VendeinRaZoR/AVC1READER/Agilent 93000 Documentation/Photos/2.bmp

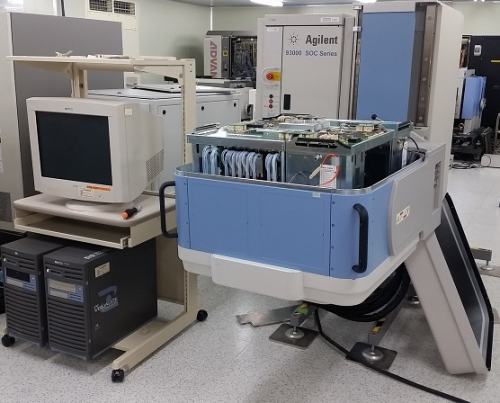
Agilent 93000 Documentation/Photos/2.bmp
