VendeinRaZoR/AVC1READER/Agilent 93000 Documentation/Photos/4.bmp

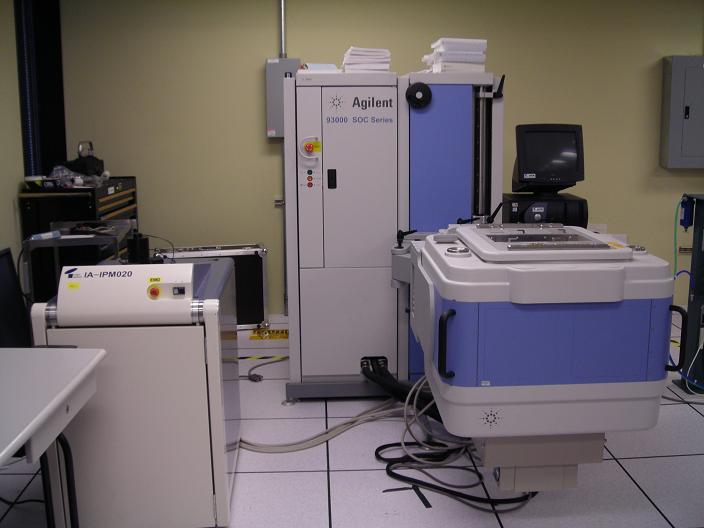
Agilent 93000 Documentation/Photos/4.bmp
