VendeinRaZoR/AVC1READER/Agilent 93000 Documentation/Photos/5.bmp

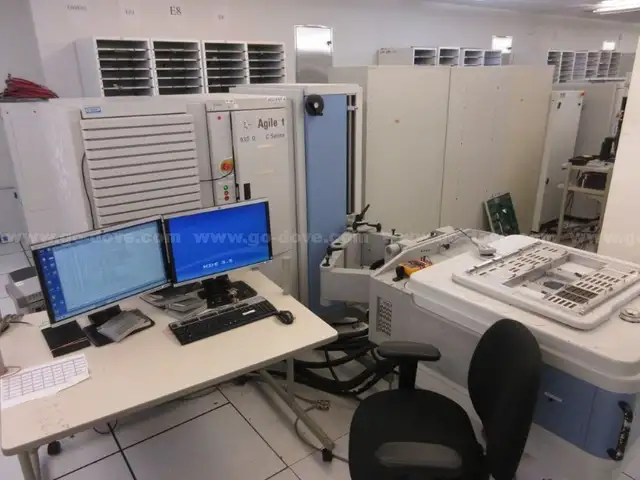
Agilent 93000 Documentation/Photos/5.bmp
