VendeinRaZoR/AVC1READER/Agilent 93000 Documentation/Photos/6.bmp

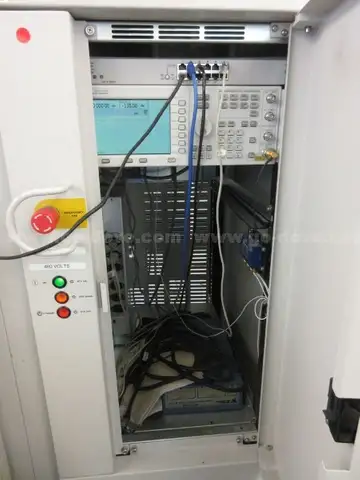
Agilent 93000 Documentation/Photos/6.bmp
