VendeinRaZoR/AVC1READER/Agilent 93000 Documentation/Photos/7.bmp

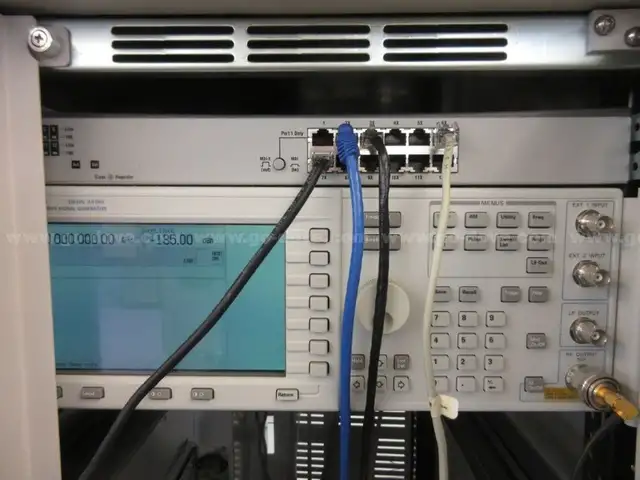
Agilent 93000 Documentation/Photos/7.bmp
