VendeinRaZoR/AVC1READER/Agilent 93000 Documentation/Photos/8.bmp

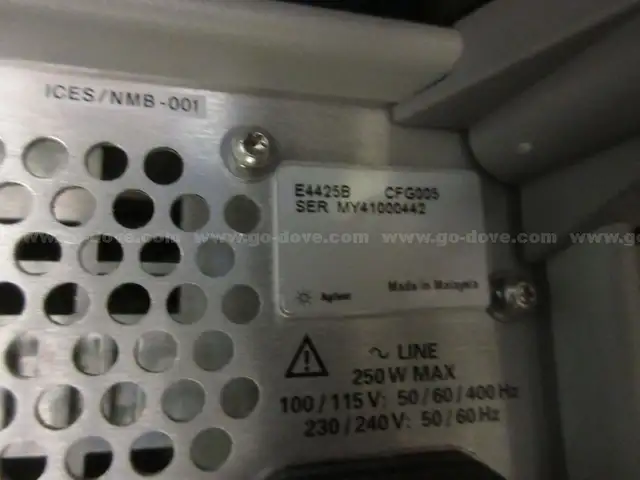
Agilent 93000 Documentation/Photos/8.bmp
