VendeinRaZoR/AVC1READER/Agilent 93000 Documentation/Photos/9.bmp

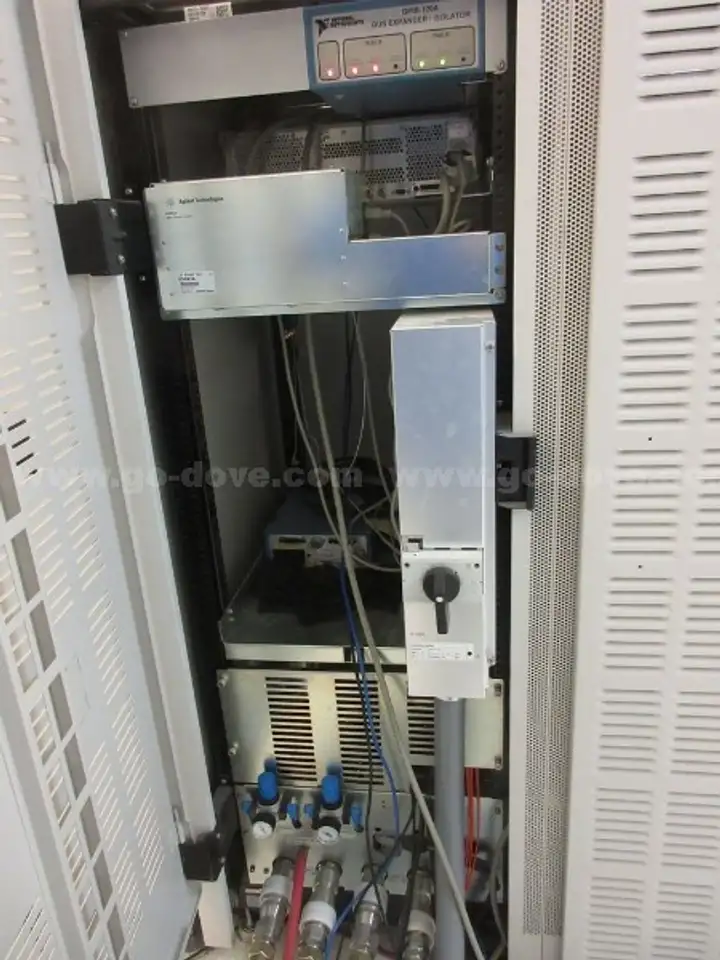
Agilent 93000 Documentation/Photos/9.bmp
