VendeinRaZoR/AVC1READER/Agilent 93000 Documentation/Photos/10.bmp

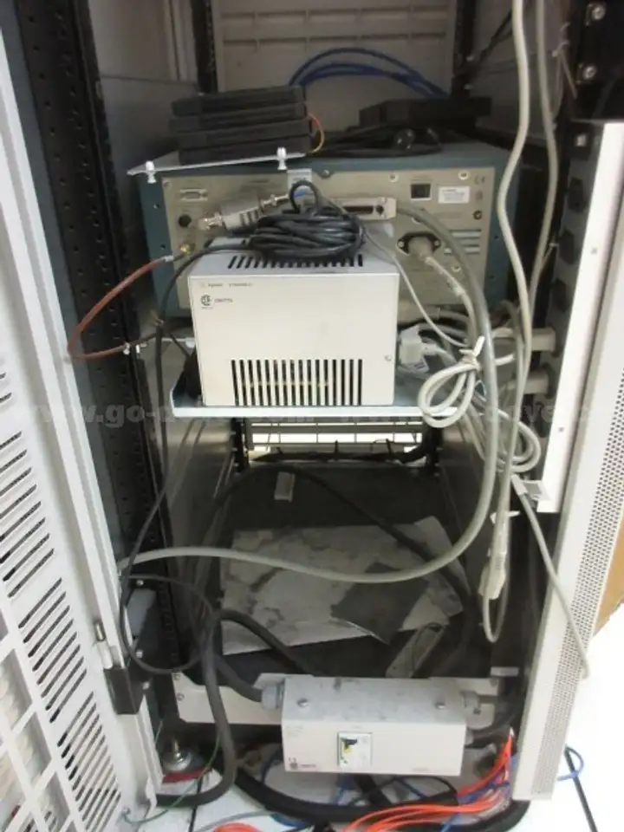
Agilent 93000 Documentation/Photos/10.bmp
