VendeinRaZoR/AVC1READER/Agilent 93000 Documentation/Photos/11.bmp

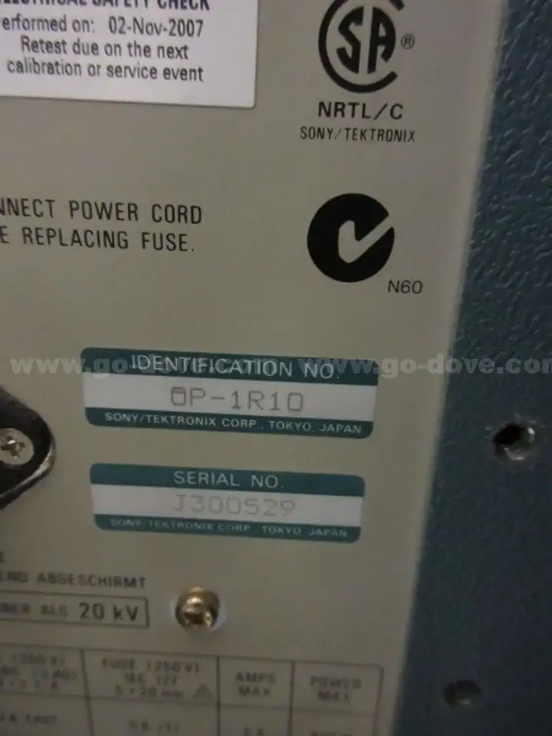
Agilent 93000 Documentation/Photos/11.bmp
