VendeinRaZoR/AVC1READER/Agilent 93000 Documentation/Photos/12.bmp

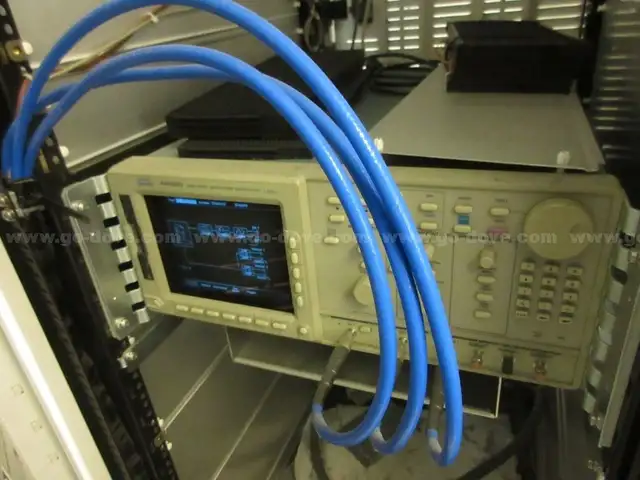
Agilent 93000 Documentation/Photos/12.bmp
