VendeinRaZoR/AVC1READER/Agilent 93000 Documentation/Photos/13.bmp

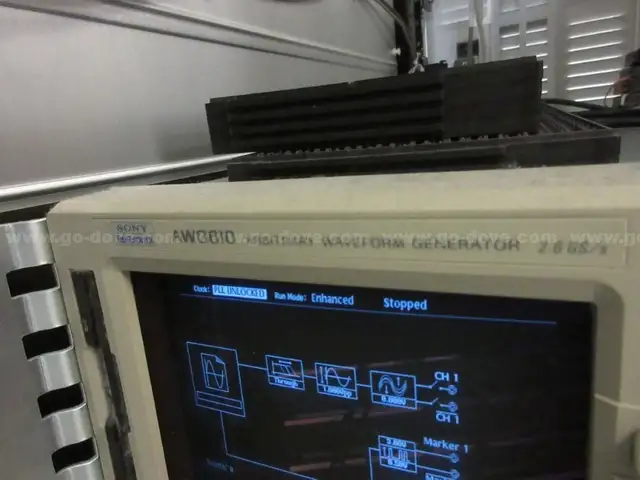
Agilent 93000 Documentation/Photos/13.bmp
