VendeinRaZoR/AVC1READER/Agilent 93000 Documentation/Photos/14.bmp

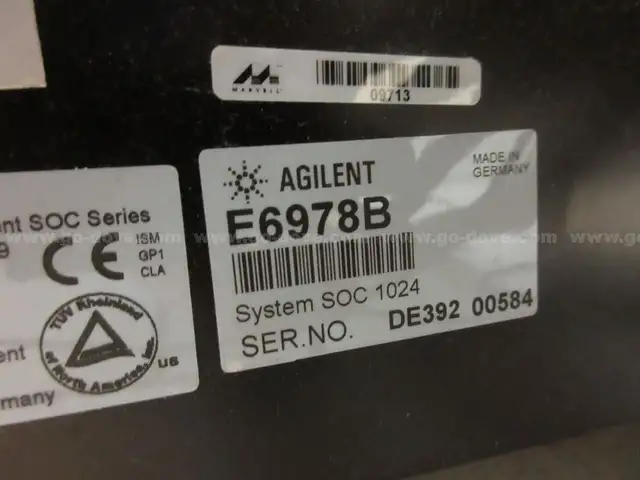
Agilent 93000 Documentation/Photos/14.bmp
