VendeinRaZoR/AVC1READER/Agilent 93000 Documentation/Photos/15.bmp

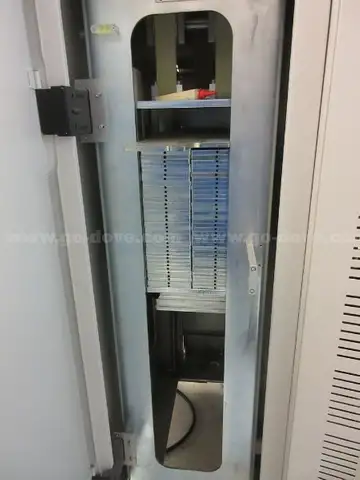
Agilent 93000 Documentation/Photos/15.bmp
