VendeinRaZoR/AVC1READER/Agilent 93000 Documentation/Photos/16.bmp

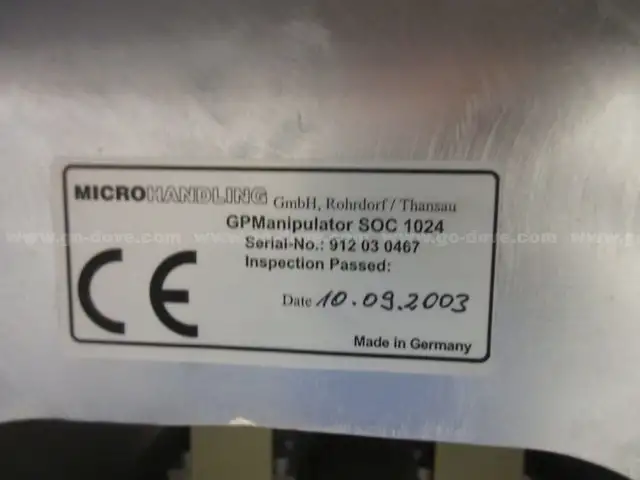
Agilent 93000 Documentation/Photos/16.bmp
