VendeinRaZoR/AVC1READER/Agilent 93000 Documentation/Photos/17.bmp

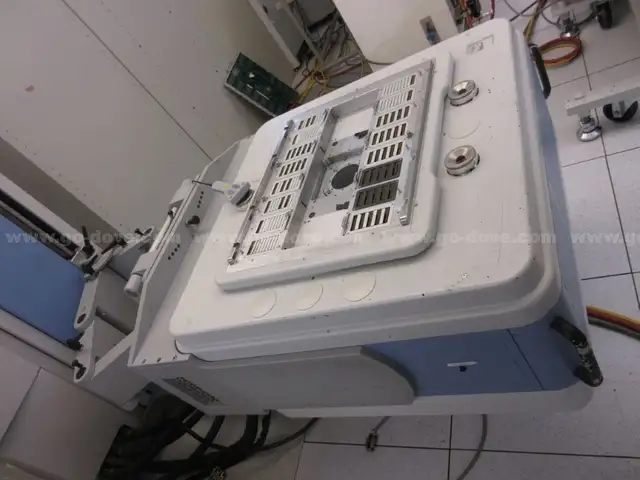
Agilent 93000 Documentation/Photos/17.bmp
