VendeinRaZoR/AVC1READER/Agilent 93000 Documentation/Photos/18.bmp

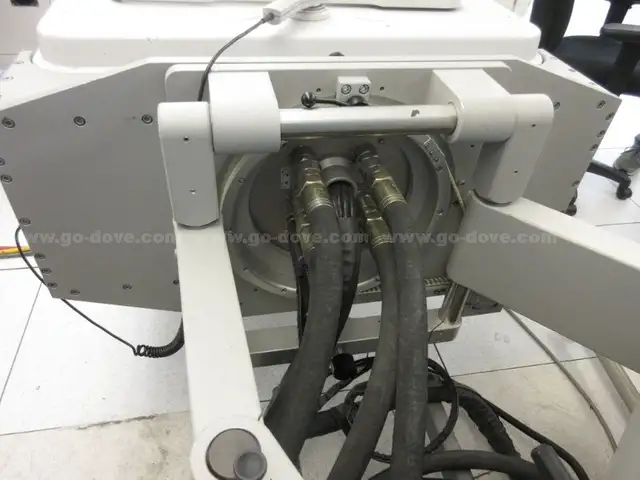
Agilent 93000 Documentation/Photos/18.bmp
