VendeinRaZoR/AVC1READER/Agilent 93000 Documentation/Photos/19.bmp

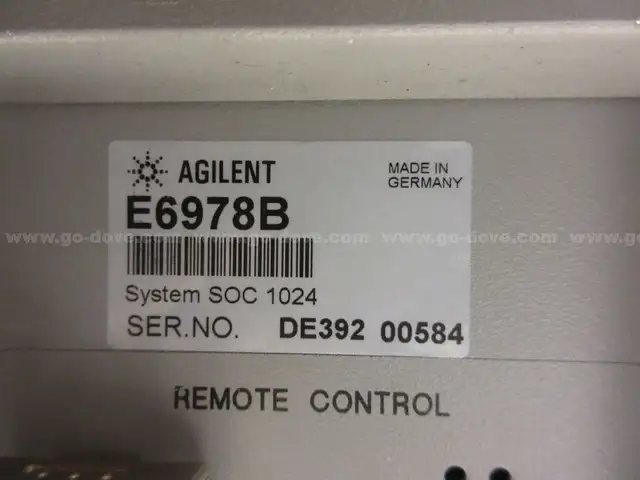
Agilent 93000 Documentation/Photos/19.bmp
