VendeinRaZoR/AVC1READER/Agilent 93000 Documentation/Photos/20.bmp

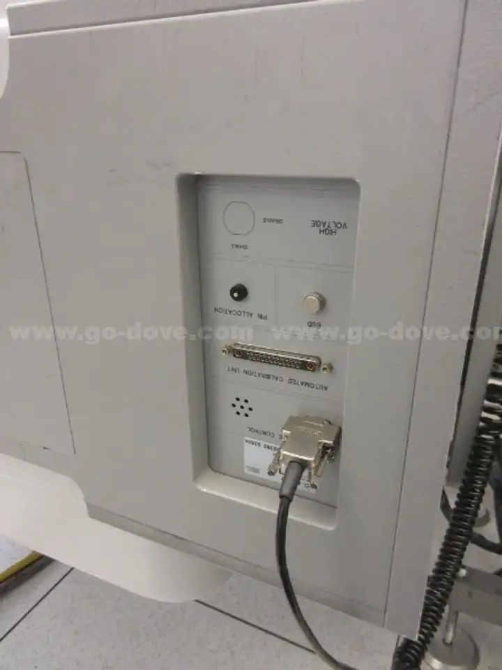
Agilent 93000 Documentation/Photos/20.bmp
