VendeinRaZoR/AVC1READER/Agilent 93000 Documentation/Photos/21.bmp

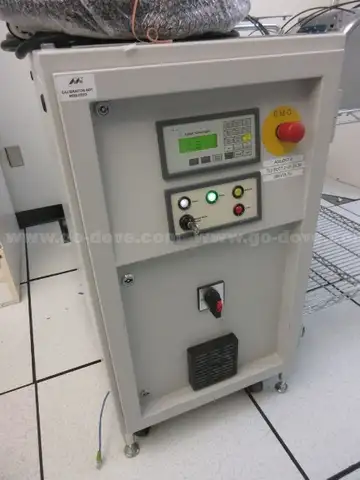
Agilent 93000 Documentation/Photos/21.bmp
