VendeinRaZoR/AVC1READER/Agilent 93000 Documentation/Photos/22.bmp

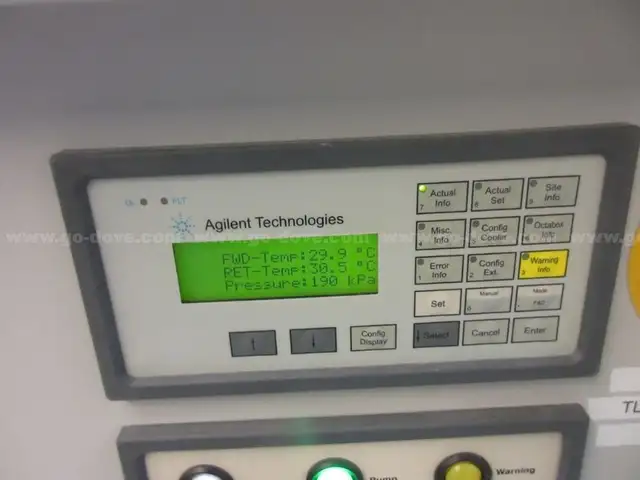
Agilent 93000 Documentation/Photos/22.bmp
