VendeinRaZoR/AVC1READER/Agilent 93000 Documentation/Photos/23.bmp

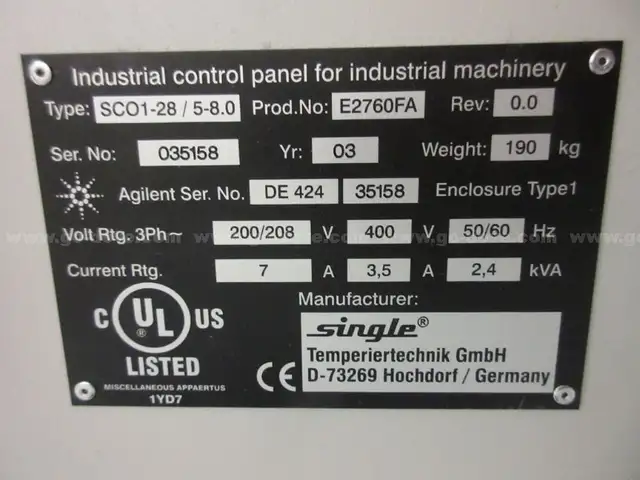
Agilent 93000 Documentation/Photos/23.bmp
