VendeinRaZoR/AVC1READER/Agilent 93000 Documentation/Photos/24.bmp

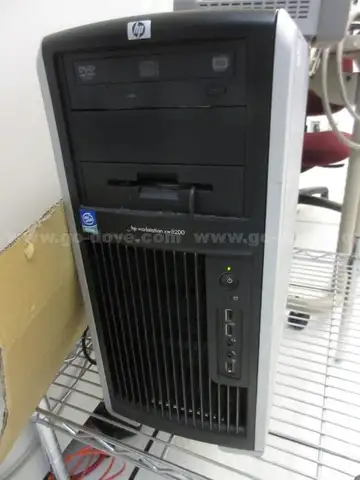
Agilent 93000 Documentation/Photos/24.bmp
