VendeinRaZoR/AVC1READER/Agilent 93000 Documentation/Photos/26.bmp

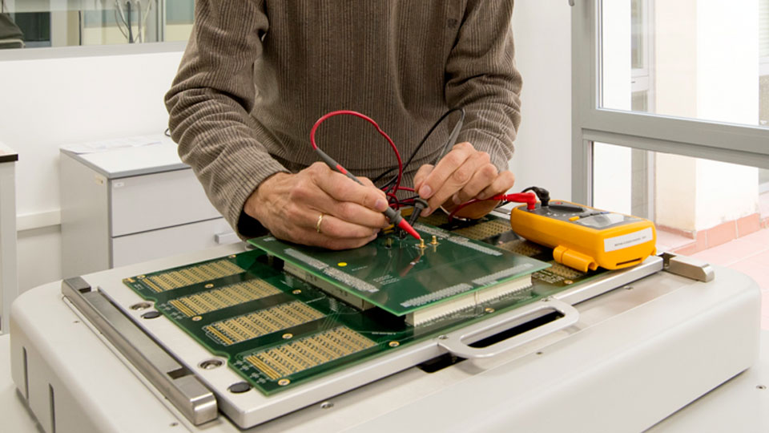
Agilent 93000 Documentation/Photos/26.bmp
