VendeinRaZoR/AVC1READER/Agilent 93000 Documentation/Photos/27.bmp

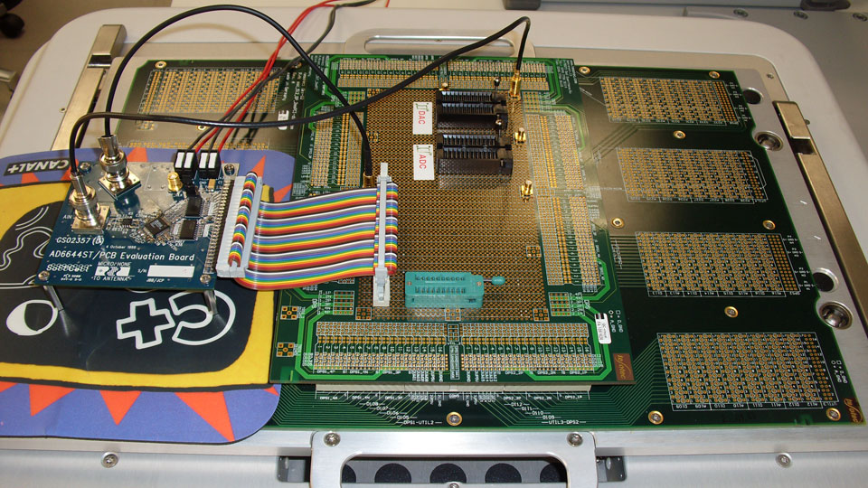
Agilent 93000 Documentation/Photos/27.bmp
