VendeinRaZoR/AVC1READER/Agilent 93000 Documentation/Photos/28.bmp

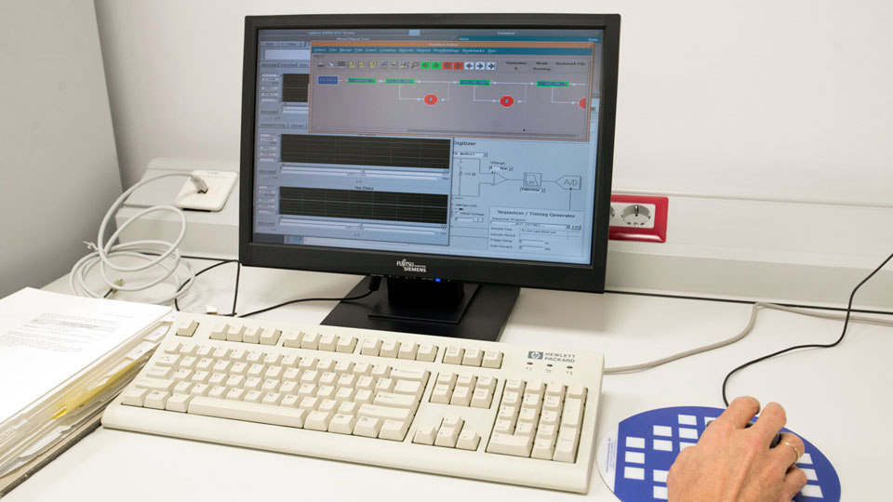
Agilent 93000 Documentation/Photos/28.bmp
