VendeinRaZoR/AVC1READER/Agilent 93000 Documentation/Photos/29.bmp

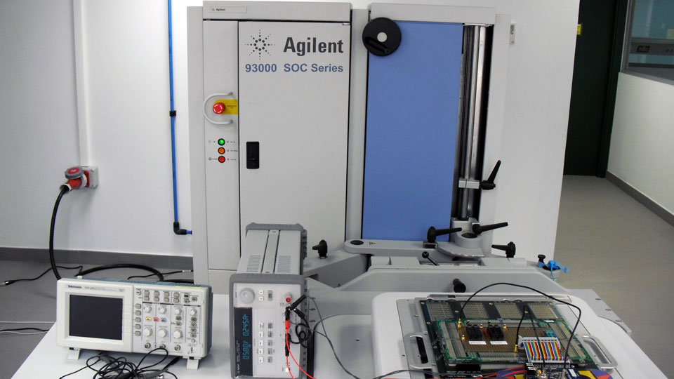
Agilent 93000 Documentation/Photos/29.bmp
