VendeinRaZoR/AVC1READER/Agilent 93000 Documentation/Photos/30.bmp

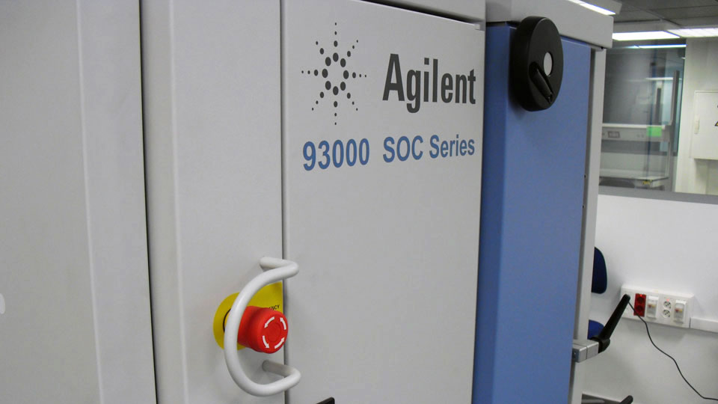
Agilent 93000 Documentation/Photos/30.bmp
