VendeinRaZoR/AVC1READER/Agilent 93000 Documentation/Photos/pogo_tower.bmp

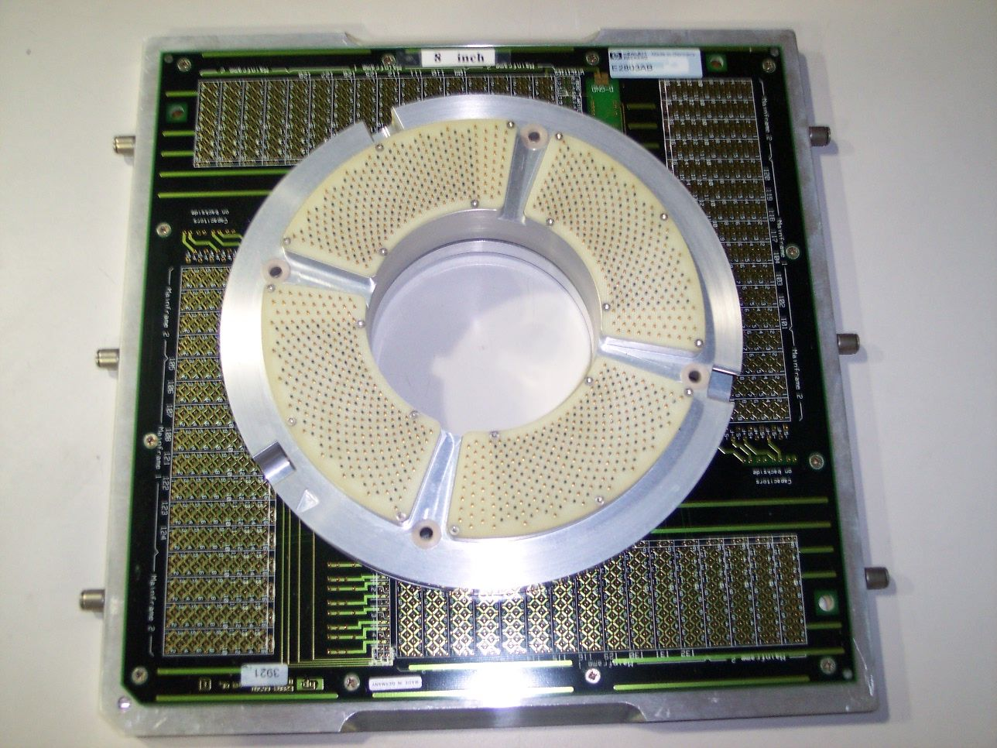
Agilent 93000 Documentation/Photos/pogo_tower.bmp
