VendeinRaZoR/AVC1READER/Verilog/AVC/avcparser.v

 /*#########################################################*/
/*###################====AVC PARSER====#####################*/
/*##########################################################*/
/*Description:
AVC parser finds 3-state and input signals in AVC file 
and brings them into parallel form for SDRAM
*/
module avcparser(
input clk, //Clock
input ureset, ///User reset (by START button)
input sbdone, /// shift byte done
input endpkt, ///end of DATA packet
input isdpkt, ///is DATA packet on DAT line 
input avcrden,///AVC_READ_DATA state enabled
input [7:0] DATASI, ///Data serial input SD CARD shift register output
output [31:0] AVCVECNTR, ///AVC file vector counter while reading from SD CARD
output [127:0] AVCPSGNL, ///AVC files signals in parallel form for output on IDE connector 
output [127:0] TRSTPSGNL, ///output enable signals for output signals on IDE connector
output [127:0] HLPSGNL, ///is current signal is input H or L signal parallel (128 signals but 16 used only)
output eofavc, ///End-of-File AVC file
output eofavcfnd, ///found End-of-File in AVC file
output resprdspntr, ///Reset AVC file sector pointer
output notstsgnls ///No 3-state signals
);

reg R_EOFAVC; ///End-of-File AVC register
reg R_EOFAVCFND; ///End-of-File AVC found register
reg [127:0] R_HLVEC; ///3-state control for output signals on IDE connector (128 signals but 16 used only)
reg [31:0] R_AVCVECNTR; ///AVC vector counter
reg [127:0] R_AVCPSGNL; ///AVC vector signals in parallel form (128 signals but 16 used only)
reg [127:0] R_TRSTPSGNL; ///Direction of signals in parallel form (128 signals but 16 used only) 
reg [6:0] R_AVCHRCNTR; ///AVC char (bits) counter in AVC vector
reg [127:0] R_HLPSGNL; ///is current signal is input H or L signal parallel (128 signals but 16 used only)
reg [127:0] R_TSSGNLNUM; ///shift AVC signal type register (input or output) (128 signals but 16 used only)

assign TRSTPSGNL = R_TRSTPSGNL;

assign eofavc = R_EOFAVC;
assign eofavcfnd = R_EOFAVCFND;
assign AVCPSGNL = R_AVCPSGNL;

assign AVCVECNTR = R_AVCVECNTR;

assign resprdspntr = R_AVCVECNTR == 0;

assign notstsgnls = R_HLVEC == 0;

assign HLPSGNL = R_HLPSGNL;

/////////////////////////////AVC FILE PARSER STAGE/////////////////////////
//////////End-Of-File AVC indicator
always@(posedge ureset or negedge clk)
begin
	if(ureset)
		R_EOFAVC <= 0;
	else
	begin
		if(sbdone & avcrden & endpkt & isdpkt & eofavcfnd & DATASI == 8'h00 & R_AVCVECNTR != 0)
			R_EOFAVC <= 1;
	end
end
//////////End-Of-File AVC already found indicator
always@(posedge ureset or negedge clk)
begin
	if(ureset)
		R_EOFAVCFND <= 0;
	else
	begin
		if(sbdone & avcrden & endpkt & isdpkt & DATASI == 8'h00)
			R_EOFAVCFND <= 1;
	end
end

//////////AVC File Vector counter
always@(posedge ureset or negedge clk)
begin
	if(ureset)
		R_AVCVECNTR <= 32'h0000_0000;
	else
	begin
		if(sbdone & avcrden & endpkt & isdpkt & !eofavcfnd & DATASI == 8'h00)
			R_AVCVECNTR <= 32'h0000_0000;
		else if(sbdone & avcrden & endpkt & isdpkt & DATASI == 8'h0A)
			R_AVCVECNTR <= R_AVCVECNTR + 32'h0000_0001;   
	end
end
//////////AVC Char counter counts signals in 1 vector
always@(posedge ureset or negedge clk)
begin
	if(ureset)
		R_AVCHRCNTR <= 7'h00;
	else
	begin
		if(sbdone & avcrden & endpkt & isdpkt & R_AVCVECNTR != 32'h0)
		begin
		
			case(DATASI)
		
				8'h0A:
					R_AVCHRCNTR <= 7'h00;
				
				8'h00:
					R_AVCHRCNTR <= 7'h00;
					
				8'h30:
					R_AVCHRCNTR <= R_AVCHRCNTR + 1'b1;
					
				8'h31:
					R_AVCHRCNTR <= R_AVCHRCNTR + 1'b1;
				
				8'h78:
					R_AVCHRCNTR <= R_AVCHRCNTR + 1'b1;
					
				8'h7A:
					R_AVCHRCNTR <= R_AVCHRCNTR + 1'b1;
					
				8'h48:
					R_AVCHRCNTR <= R_AVCHRCNTR + 1'b1;
				
				8'h4C:
					R_AVCHRCNTR <= R_AVCHRCNTR + 1'b1;
					
			endcase
		end
	end
end
//////////fetch register containing H & L signals of vector in parallel form when reach End-Of-Line
always@(posedge ureset or negedge clk)
begin
	if(ureset)
	begin
		R_HLVEC <= 0;
	end
	else
	begin
		if(sbdone & avcrden & endpkt & isdpkt & !eofavcfnd & DATASI == 8'h0A & R_AVCVECNTR != 0)
			R_HLVEC <= R_HLVEC | R_HLPSGNL;
	end
end
//////////AVC vector in parallel form composed from particular signals
always@(posedge ureset or negedge clk)
begin
	if(ureset)
		R_AVCPSGNL <= 0;
	else
	begin
		if(sbdone & avcrden & endpkt & isdpkt & eofavcfnd & R_AVCVECNTR != 0)
		begin
			if(DATASI == 8'h30 | DATASI == 8'h31 | DATASI == 8'h78 | DATASI == 8'h7A | DATASI == 8'h48 | DATASI == 8'h4C)
			begin
				case(R_AVCHRCNTR)
				
				0: R_AVCPSGNL[127] <= 0; 
				1: R_AVCPSGNL[0] <= (DATASI == 8'h31 | DATASI == 8'h48); 
				2: R_AVCPSGNL[1] <= (DATASI == 8'h31 | DATASI == 8'h48); 
				3: R_AVCPSGNL[2] <= (DATASI == 8'h31 | DATASI == 8'h48);  
				4: R_AVCPSGNL[3] <= (DATASI == 8'h31 | DATASI == 8'h48); 
				5: R_AVCPSGNL[4] <= (DATASI == 8'h31 | DATASI == 8'h48); 
				6: R_AVCPSGNL[5] <= (DATASI == 8'h31 | DATASI == 8'h48); 
				7: R_AVCPSGNL[6] <= (DATASI == 8'h31 | DATASI == 8'h48); 
				8: R_AVCPSGNL[7] <= (DATASI == 8'h31 | DATASI == 8'h48); 
				9: R_AVCPSGNL[8] <= (DATASI == 8'h31 | DATASI == 8'h48); 
				10: R_AVCPSGNL[9] <= (DATASI == 8'h31 | DATASI == 8'h48); 
				11: R_AVCPSGNL[10] <= (DATASI == 8'h31 | DATASI == 8'h48); 
				12: R_AVCPSGNL[11] <= (DATASI == 8'h31 | DATASI == 8'h48); 
				13: R_AVCPSGNL[12] <= (DATASI == 8'h31 | DATASI == 8'h48); 
				14: R_AVCPSGNL[13] <= (DATASI == 8'h31 | DATASI == 8'h48); 
				15: R_AVCPSGNL[14] <= (DATASI == 8'h31 | DATASI == 8'h48); 
				16: R_AVCPSGNL[15] <= (DATASI == 8'h31 | DATASI == 8'h48); 
				17: R_AVCPSGNL[16] <= (DATASI == 8'h31 | DATASI == 8'h48); 
				18: R_AVCPSGNL[17] <= (DATASI == 8'h31 | DATASI == 8'h48); 
				19: R_AVCPSGNL[18] <= (DATASI == 8'h31 | DATASI == 8'h48);  
				20: R_AVCPSGNL[19] <= (DATASI == 8'h31 | DATASI == 8'h48); 
				21: R_AVCPSGNL[20] <= (DATASI == 8'h31 | DATASI == 8'h48); 
				22: R_AVCPSGNL[21] <= (DATASI == 8'h31 | DATASI == 8'h48); 
				23: R_AVCPSGNL[22] <= (DATASI == 8'h31 | DATASI == 8'h48); 
				24: R_AVCPSGNL[23] <= (DATASI == 8'h31 | DATASI == 8'h48); 
				25: R_AVCPSGNL[24] <= (DATASI == 8'h31 | DATASI == 8'h48); 
				26: R_AVCPSGNL[25] <= (DATASI == 8'h31 | DATASI == 8'h48); 
				27: R_AVCPSGNL[26] <= (DATASI == 8'h31 | DATASI == 8'h48);  
				28: R_AVCPSGNL[27] <= (DATASI == 8'h31 | DATASI == 8'h48); 
				29: R_AVCPSGNL[28] <= (DATASI == 8'h31 | DATASI == 8'h48); 
				30: R_AVCPSGNL[29] <= (DATASI == 8'h31 | DATASI == 8'h48); 
				31: R_AVCPSGNL[30] <= (DATASI == 8'h31 | DATASI == 8'h48); 
				32: R_AVCPSGNL[31] <= (DATASI == 8'h31 | DATASI == 8'h48); 
				33: R_AVCPSGNL[32] <= (DATASI == 8'h31 | DATASI == 8'h48);  
				34: R_AVCPSGNL[33] <= (DATASI == 8'h31 | DATASI == 8'h48); 
				35: R_AVCPSGNL[34] <= (DATASI == 8'h31 | DATASI == 8'h48);  
				36: R_AVCPSGNL[35] <= (DATASI == 8'h31 | DATASI == 8'h48); 
				37: R_AVCPSGNL[36] <= (DATASI == 8'h31 | DATASI == 8'h48); 
				38: R_AVCPSGNL[37] <= (DATASI == 8'h31 | DATASI == 8'h48); 
				39: R_AVCPSGNL[38] <= (DATASI == 8'h31 | DATASI == 8'h48); 
				40: R_AVCPSGNL[39] <= (DATASI == 8'h31 | DATASI == 8'h48); 
				41: R_AVCPSGNL[40] <= (DATASI == 8'h31 | DATASI == 8'h48); 
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
				107: R_AVCPSGNL[106] <= (DATASI == 8'h31 | DATASI == 8'h48); 
				108: R_AVCPSGNL[107] <= (DATASI == 8'h31 | DATASI == 8'h48); 
				109: R_AVCPSGNL[108] <= (DATASI == 8'h31 | DATASI == 8'h48); 
				110: R_AVCPSGNL[109] <= (DATASI == 8'h31 | DATASI == 8'h48); 
				111: R_AVCPSGNL[110] <= (DATASI == 8'h31 | DATASI == 8'h48); 
				112: R_AVCPSGNL[111] <= (DATASI == 8'h31 | DATASI == 8'h48); 
				113: R_AVCPSGNL[112] <= (DATASI == 8'h31 | DATASI == 8'h48); 
				114: R_AVCPSGNL[113] <= (DATASI == 8'h31 | DATASI == 8'h48); 
				115: R_AVCPSGNL[114] <= (DATASI == 8'h31 | DATASI == 8'h48); 
				116: R_AVCPSGNL[115] <= (DATASI == 8'h31 | DATASI == 8'h48); 
				117: R_AVCPSGNL[116] <= (DATASI == 8'h31 | DATASI == 8'h48); 
				118: R_AVCPSGNL[117] <= (DATASI == 8'h31 | DATASI == 8'h48); 
				119: R_AVCPSGNL[118] <= (DATASI == 8'h31 | DATASI == 8'h48); 
				120: R_AVCPSGNL[119] <= (DATASI == 8'h31 | DATASI == 8'h48); 
				121: R_AVCPSGNL[120] <= (DATASI == 8'h31 | DATASI == 8'h48); 
				122: R_AVCPSGNL[121] <= (DATASI == 8'h31 | DATASI == 8'h48); 
				123: R_AVCPSGNL[122] <= (DATASI == 8'h31 | DATASI == 8'h48); 
				124: R_AVCPSGNL[123] <= (DATASI == 8'h31 | DATASI == 8'h48);  
				125: R_AVCPSGNL[124] <= (DATASI == 8'h31 | DATASI == 8'h48); 
				126: R_AVCPSGNL[125] <= (DATASI == 8'h31 | DATASI == 8'h48); 
				127: R_AVCPSGNL[126] <= (DATASI == 8'h31 | DATASI == 8'h48); 
				
				endcase
			end
			else if(DATASI == 8'h0A | DATASI == 8'h00)
				R_AVCPSGNL <= 0;
		end
	end
end
//////////Signal's directoins in parallel form received from AVC file on SD CARD
always@(posedge ureset or negedge clk)
begin
	if(ureset)
		R_TRSTPSGNL <= 0;
	else
	begin
		if(sbdone & avcrden & endpkt & isdpkt & eofavcfnd & R_AVCVECNTR != 0)
		begin
			if(DATASI == 8'h30 | DATASI == 8'h31 | DATASI == 8'h78 | DATASI == 8'h7A | DATASI == 8'h48 | DATASI == 8'h4C)
			begin
				case(R_AVCHRCNTR)
				
				0: R_TRSTPSGNL[127] <= 0;
				1: R_TRSTPSGNL[0] <= (DATASI == 8'h78 | DATASI == 8'h7A | DATASI == 8'h48 | DATASI == 8'h4C); 
				2: R_TRSTPSGNL[1] <= (DATASI == 8'h78 | DATASI == 8'h7A | DATASI == 8'h48 | DATASI == 8'h4C); 
				3: R_TRSTPSGNL[2] <= (DATASI == 8'h78 | DATASI == 8'h7A | DATASI == 8'h48 | DATASI == 8'h4C);  
				4: R_TRSTPSGNL[3] <= (DATASI == 8'h78 | DATASI == 8'h7A | DATASI == 8'h48 | DATASI == 8'h4C); 
				5: R_TRSTPSGNL[4] <= (DATASI == 8'h78 | DATASI == 8'h7A | DATASI == 8'h48 | DATASI == 8'h4C); 
				6: R_TRSTPSGNL[5] <= (DATASI == 8'h78 | DATASI == 8'h7A | DATASI == 8'h48 | DATASI == 8'h4C); 
				7: R_TRSTPSGNL[6] <= (DATASI == 8'h78 | DATASI == 8'h7A | DATASI == 8'h48 | DATASI == 8'h4C); 
				8: R_TRSTPSGNL[7] <= (DATASI == 8'h78 | DATASI == 8'h7A | DATASI == 8'h48 | DATASI == 8'h4C); 
				9: R_TRSTPSGNL[8] <= (DATASI == 8'h78 | DATASI == 8'h7A | DATASI == 8'h48 | DATASI == 8'h4C); 
				10: R_TRSTPSGNL[9] <= (DATASI == 8'h78 | DATASI == 8'h7A | DATASI == 8'h48 | DATASI == 8'h4C); 
				11: R_TRSTPSGNL[10] <= (DATASI == 8'h78 | DATASI == 8'h7A | DATASI == 8'h48 | DATASI == 8'h4C); 
				12: R_TRSTPSGNL[11] <= (DATASI == 8'h78 | DATASI == 8'h7A | DATASI == 8'h48 | DATASI == 8'h4C); 
				13: R_TRSTPSGNL[12] <= (DATASI == 8'h78 | DATASI == 8'h7A | DATASI == 8'h48 | DATASI == 8'h4C); 
				14: R_TRSTPSGNL[13] <= (DATASI == 8'h78 | DATASI == 8'h7A | DATASI == 8'h48 | DATASI == 8'h4C); 
				15: R_TRSTPSGNL[14] <= (DATASI == 8'h78 | DATASI == 8'h7A | DATASI == 8'h48 | DATASI == 8'h4C); 
				16: R_TRSTPSGNL[15] <= (DATASI == 8'h78 | DATASI == 8'h7A | DATASI == 8'h48 | DATASI == 8'h4C); 
				17: R_TRSTPSGNL[16] <= (DATASI == 8'h78 | DATASI == 8'h7A | DATASI == 8'h48 | DATASI == 8'h4C); 
				18: R_TRSTPSGNL[17] <= (DATASI == 8'h78 | DATASI == 8'h7A | DATASI == 8'h48 | DATASI == 8'h4C); 
				19: R_TRSTPSGNL[18] <= (DATASI == 8'h78 | DATASI == 8'h7A | DATASI == 8'h48 | DATASI == 8'h4C);  
				20: R_TRSTPSGNL[19] <= (DATASI == 8'h78 | DATASI == 8'h7A | DATASI == 8'h48 | DATASI == 8'h4C); 
				21: R_TRSTPSGNL[20] <= (DATASI == 8'h78 | DATASI == 8'h7A | DATASI == 8'h48 | DATASI == 8'h4C); 
				22: R_TRSTPSGNL[21] <= (DATASI == 8'h78 | DATASI == 8'h7A | DATASI == 8'h48 | DATASI == 8'h4C); 
				23: R_TRSTPSGNL[22] <= (DATASI == 8'h78 | DATASI == 8'h7A | DATASI == 8'h48 | DATASI == 8'h4C); 
				24: R_TRSTPSGNL[23] <= (DATASI == 8'h78 | DATASI == 8'h7A | DATASI == 8'h48 | DATASI == 8'h4C); 
				25: R_TRSTPSGNL[24] <= (DATASI == 8'h78 | DATASI == 8'h7A | DATASI == 8'h48 | DATASI == 8'h4C); 
				26: R_TRSTPSGNL[25] <= (DATASI == 8'h78 | DATASI == 8'h7A | DATASI == 8'h48 | DATASI == 8'h4C); 
				27: R_TRSTPSGNL[26] <= (DATASI == 8'h78 | DATASI == 8'h7A | DATASI == 8'h48 | DATASI == 8'h4C);  
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
				126: R_HLPSGNL[125] <= (DATASI == 8'h4C | DATASI == 8'h48); 
				127: R_HLPSGNL[126] <= (DATASI == 8'h4C | DATASI == 8'h48); 
				
				endcase
			end
			else if(DATASI == 8'h0A | DATASI == 8'h00)
				R_HLPSGNL <= 0;
		end
	end
end

endmodule 
